MrG4dget/BalCCon_Video_Wall/media/02_balccon_2k18_wall.gif

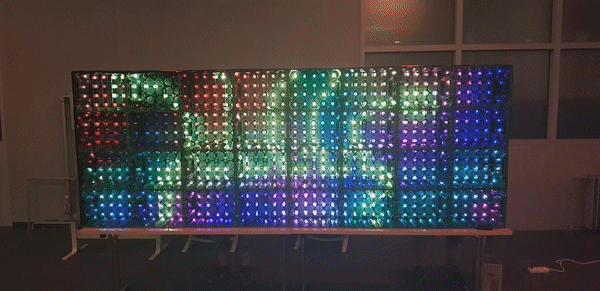
media/02_balccon_2k18_wall.gif
