MrG4dget/BalCCon_Video_Wall/media/03_BalcCon_Wall-V1.0.jpg

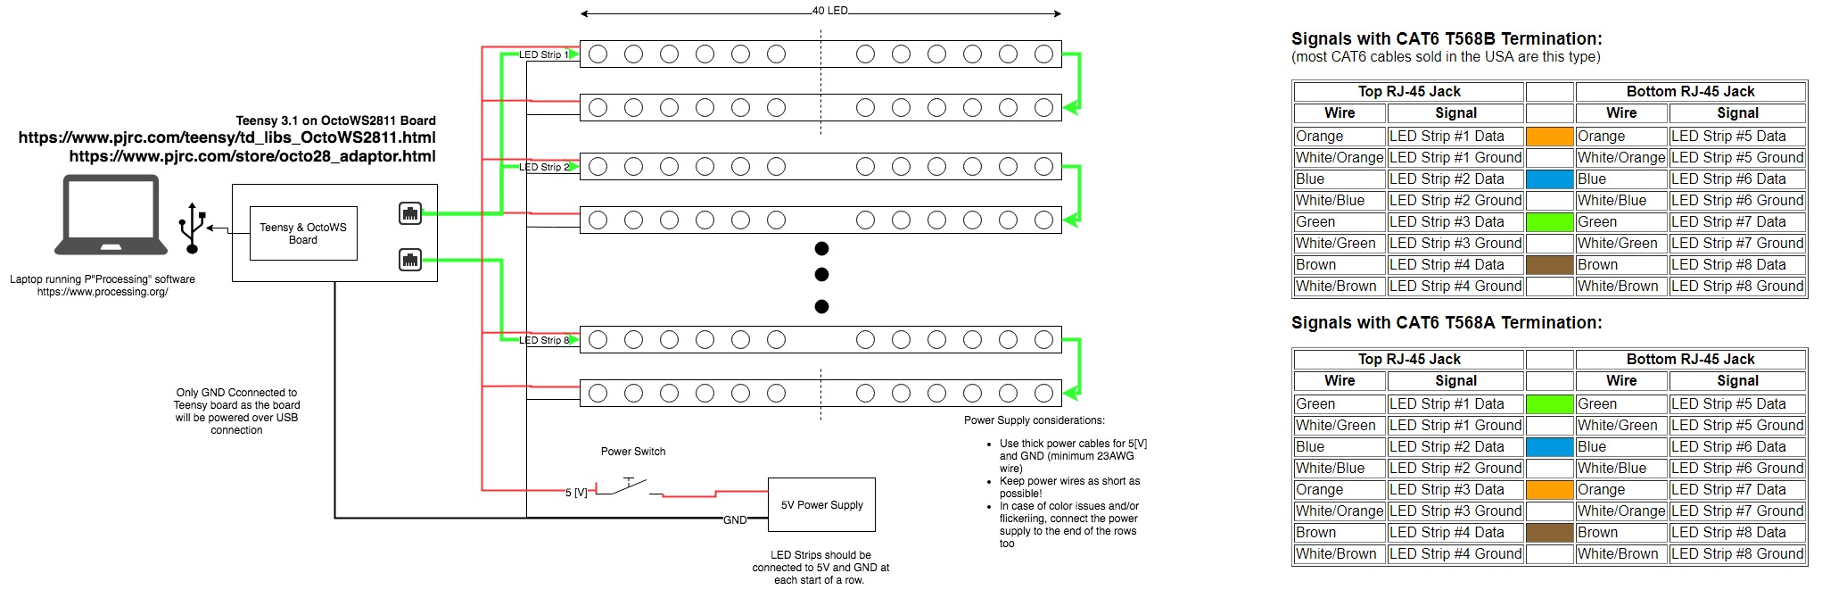
media/03_BalcCon_Wall-V1.0.jpg
