MrG4dget/BalCCon_Video_Wall/media/P1022042.jpeg

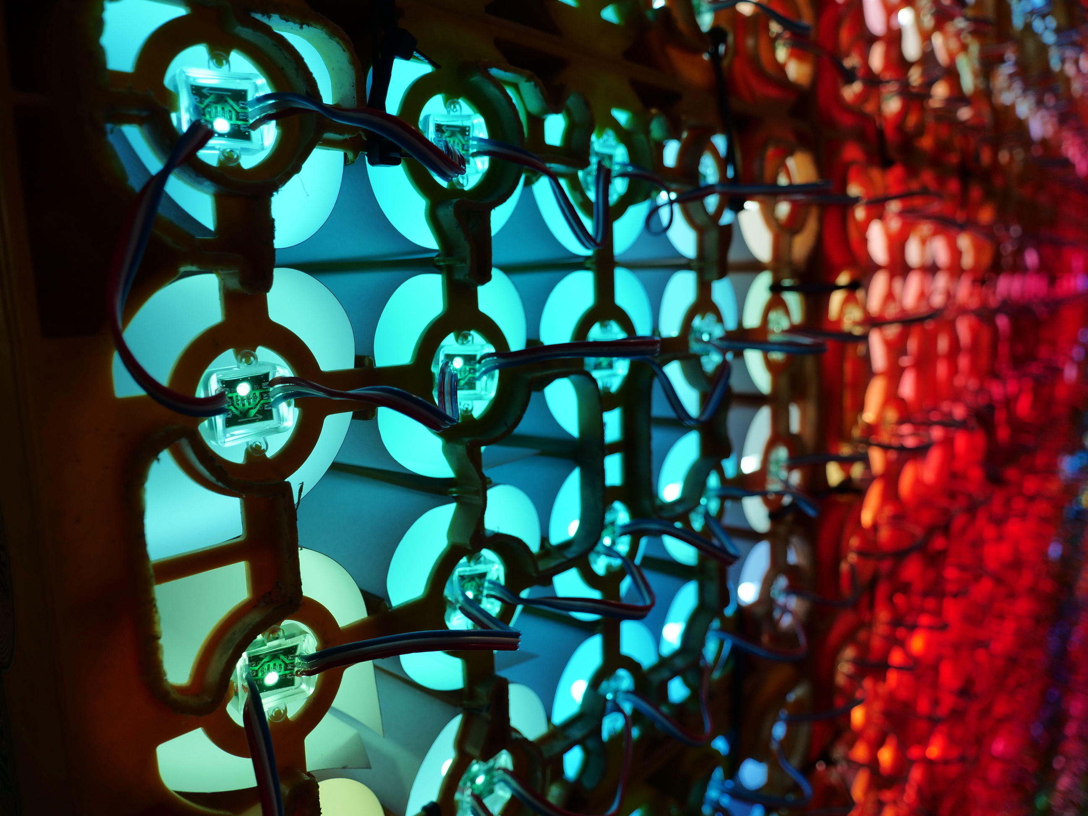
media/P1022042.jpeg
