MrG4dget/BalCCon_Video_Wall/media/Wall_1.jpg

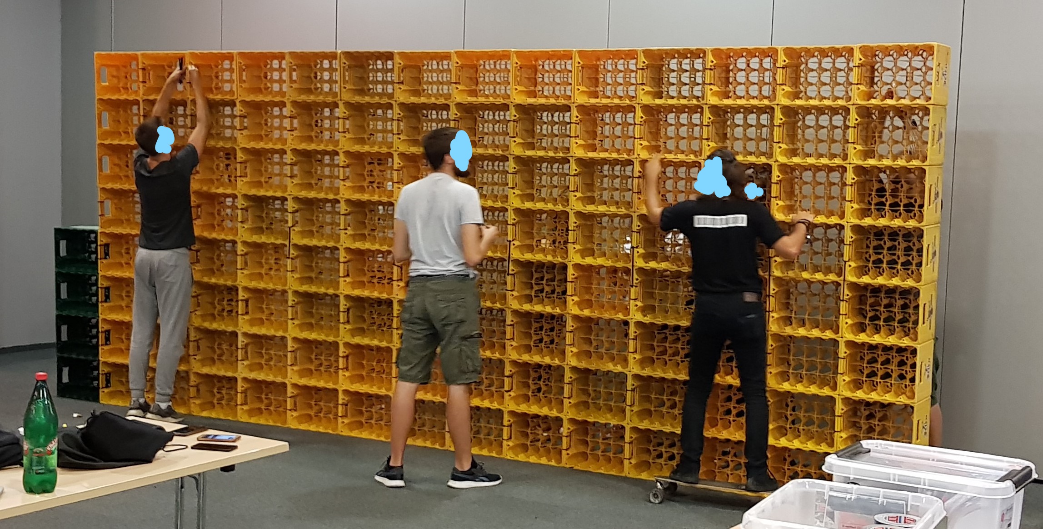
media/Wall_1.jpg
